GO3R/Makerbot-RFID-Cloner/Pictures/IMG_20241216_104319149.jpg

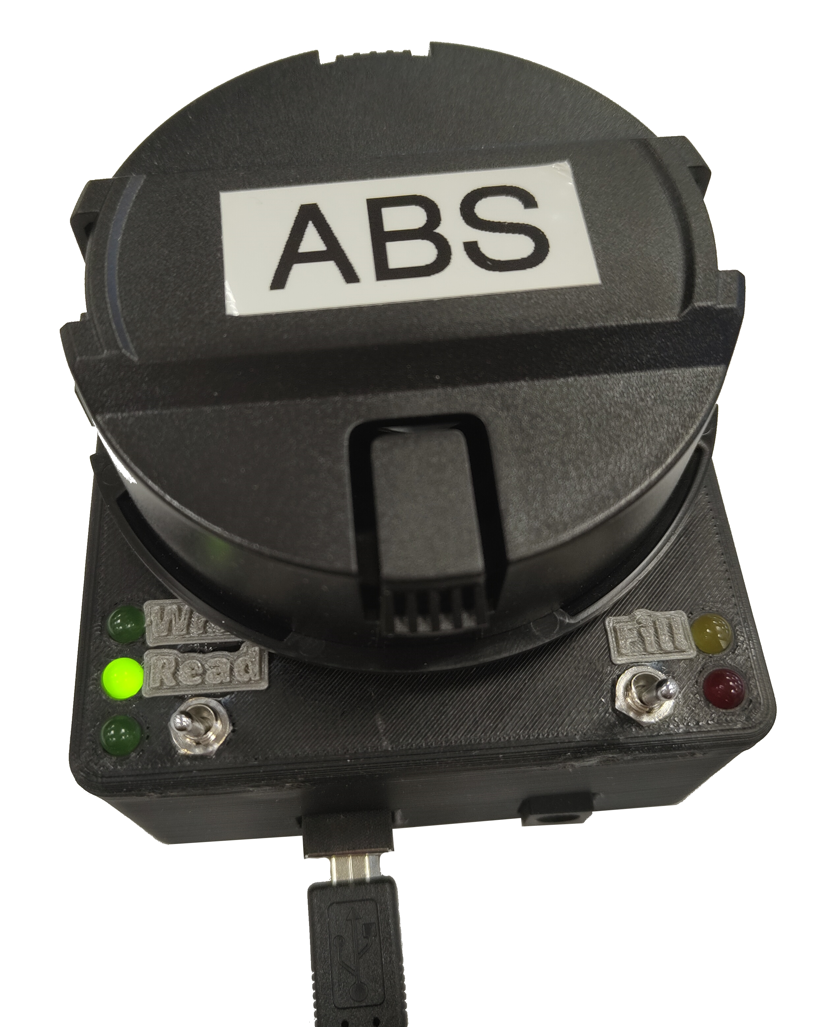
Pictures/IMG_20241216_104319149.jpg
