GO3R/Makerbot-RFID-Cloner/Pictures/IMG_20250312_114838785.jpg

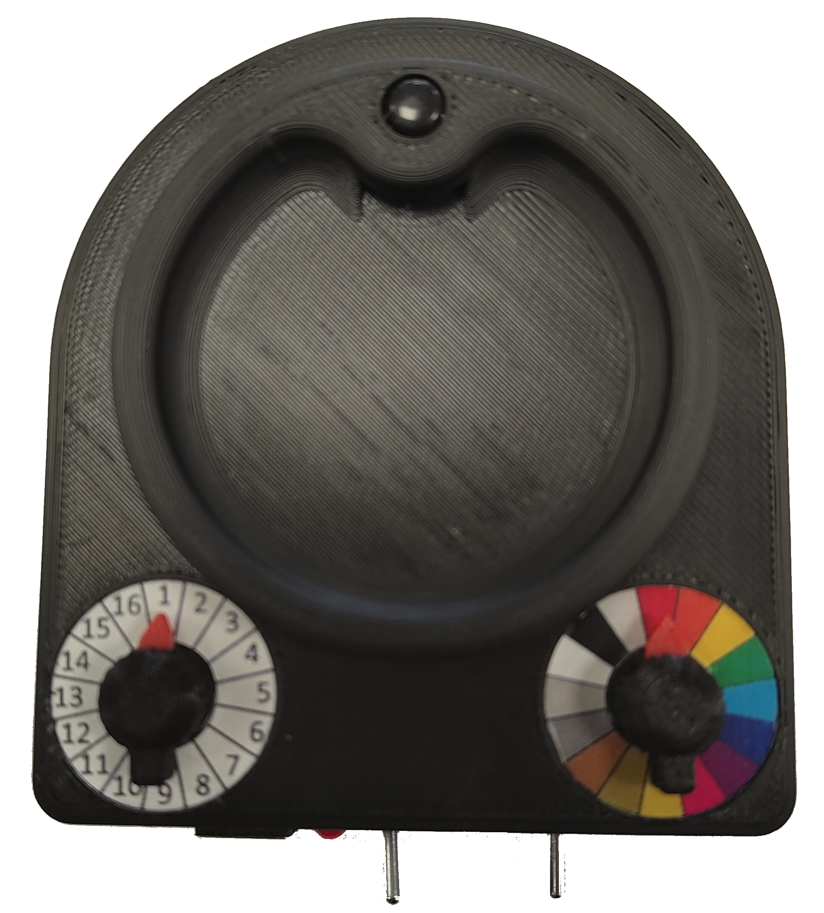
Pictures/IMG_20250312_114838785.jpg
