GO3R/Makerbot-RFID-Cloner/README.md

Two versions available! 

I have a lot of empty SR-30 spools and i respool them with ABS (its way cheaper than buing original from Makerbot). The one problem with that is, i only have one ABS RFID chip. So i made my own RFID cloner for these chips.

You can only duplicate existing RFID tags from your spools. You can not use this product to make a new material. 

I "reverse engeneered" the original RFID tag contents for you, but i will not share that. Makerbot please do not sue me :) 

You need the following Library: https://github.com/ATrappmann/PN5180-Library

3D-Model and circuit board (both not necessary for the function, but it looks nicer) is attached. Hard wiring is possible, but extremely difficult, because you dont have much space in the enclosure. 

Version 2.0 of my Makerbot Method X RFID Coil Cloner is finally finished. Unfortunately, I had to remove the clone function, but you can still select all 16 materials and 16 different colors and read the tag in the serial monitor. Plus, you can now use the device from anywhere thanks to the integrated 9V battery.

I removed four LEDs because I needed the pins from the Arduino, so only one 220 ohm resistor is needed. A switch (previously used to fill the coil) was repurposed. This switches the battery supply to the Arduino. Pull-up resistors are now used for the switches and buttons, making the 10k ohm resistors unnecessary. The circuit board has been completely redesigned. Two OTAX KMR162s were added to allow material and color selection.

Unfortunately, I don't have all the materials, so the machine can't create them all. I have ABS, ASA, Nylon, NylonCF, PC-ABS, PETG, PLA, Tough, PVA, and SR-30. I don't have the MakerBot hex code for any other materials. If you have these materials, please send me the hex code (the output from the serial monitor). I will then expand the code a little bit until it's complete.

V2.1: I have addet two more Materials NylonCF and Tough (that is the special more tough PLA). To update from V2 to V2.1, you only need to flash the new Makerbot_RFIDV2.1.ino on your RFID Cloner.

V2.2: We now have ABS-R thanks to https://github.com/kosmostrater.

V2.3: We now have Nylon12CF thanks to https://github.com/domomb .



HOW TO USE THIS PRODUCT IN V1________________________________________________________________________________________

The first switch is switching between read and write. (one green LED is a status LED, one is for read and one is for write)

With the second switch you can choose to fill up the spool or not (Yellow LED on = fill spool).

You can start the read and write function with the button. The LED is blinking, when its either reading or writing. 

Green status LED = Success

Red status LED = Something went wrong (You can see what in the serial monitor on your PC)

You can read one RFID tag and copy it as often as you want.

You can not read one RFID tag and write to the same with the same data (you can't "fill" the spool directly)

HOW TO USE THIS PRODUCT IN V2________________________________________________________________________________________

One switch ist an OnOff switch, the other is the Read-Write selector switch. 

Select read and connect the device to your computer with a serial monitor. add an RFID Tag and read it.

Select write, a material and a colour, add the RFID Tag and write the material. 

HARDWARE YOU NEED V1________________________________________________________________________________________

1X Arduino UNO R3 (https://www.reichelt.de/arduino-uno-rev-3-dip-variante-atmega328-usb-arduino-uno-dip-p154902.html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)

1X Adafruit bidirectional level shifter (https://www.reichelt.de/entwicklerboards-bidirektionaler-logikpegelkonverter-4-kanal--debo-logic-4ch-p235503.html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)

1X PN5180 RFID Reader (I only found them for sale in China ; https://www.ebay.de/itm/162768430788?srsltid=AfmBOop9j9C-VffmtjEJo-Qw5yhp8ghc4ka8X3xlJzSkLfzv2_8m_6zh)

1X Button (https://www.reichelt.de/miniatur-drucktaster-0-5a-24vac-1x-ein-sw-t-113a-sw-p45167.html?&trstct=vrt_pdn&nbc=1)

2X Switch (https://www.reichelt.de/kippschalter-6a-125vac-1x-ein-ein-ms-500a-p13150.html?&trstct=pol_0&nbc=1)

3X LED Green (https://www.reichelt.de/led-5mm-bedrahtet-gruen-2000-mcd-60--5034g3d-esa-a-p361637.html?&trstct=pos_7&nbc=1)

1X LED Yellow (https://www.reichelt.de/led-5mm-bedrahtet-gelb-130-mcd-60--5003y1d-ehb-a-p361633.html?&trstct=pos_5&nbc=1)

1X LED Red (https://www.reichelt.de/led-5-mm-bedrahtet-rot-fr-led-5-rd-dif-p230933.html?&trstct=pos_1&nbc=1)

5X 220Ohm Resistor (https://www.reichelt.de/widerstand-metallschicht-220-ohm-0207-0-6-0-1--mpr-220-p12875.html?&trstct=pos_0&nbc=1)

4X 10KOhm Resistor (https://www.reichelt.de/widerstand-metallschicht-10-kohm-axial-1-w-5--vis-pr0100010105-p237110.html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)

JST XH connectors, i buy them in a set (https://www.ebay.de/itm/175923966477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)
(7X 2Pin, 1X 3Pin, 1X 4Pin, 1X5Pin)

2X female headers 6 pin (https://www.reichelt.de/buchsenleisten-2-54-mm-1x06-gerade-mpe-094-1-006-p119915.html?&trstct=pol_7&nbc=1) (you don't need them, if you solder the level shifter in place)

1X male headers (https://www.reichelt.de/stiftleisten-2-54-mm-1x24-gerade-mpe-087-1-024-p119889.html?&trstct=pol_11&nbc=1) (you need at least 19 Pins for the Arduino and 12 for the level shifter)

8X M3x5 screw (https://www.ebay.de/itm/371713576275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) (for fixing the RFID reader and the Arduino)

4X M3x10 screw (https://www.ebay.de/itm/371713576275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) (for closing the enclosure)

12X M3x4 Heat set insert (https://www.ebay.de/itm/365099517164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) (Optional)

Soldering iron and wires to connect it

3D Printer for the case

HARDWARE YOU NEED V2________________________________________________________________________________________

1X Arduino UNO R3 (https://www.reichelt.de/arduino-uno-rev-3-dip-variante-atmega328-usb-arduino-uno-dip-p154902.html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)

1X Adafruit bidirectional level shifter (https://www.reichelt.de/entwicklerboards-bidirektionaler-logikpegelkonverter-4-kanal--debo-logic-4ch-p235503.html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)

1X PN5180 RFID Reader (I only found them for sale in China ; https://www.ebay.de/itm/162768430788?srsltid=AfmBOop9j9C-VffmtjEJo-Qw5yhp8ghc4ka8X3xlJzSkLfzv2_8m_6zh)

1X Button (https://www.reichelt.de/miniatur-drucktaster-0-5a-24vac-1x-ein-sw-t-113a-sw-p45167.html?&trstct=vrt_pdn&nbc=1)

2X Switch (https://www.reichelt.de/kippschalter-6a-125vac-1x-ein-ein-ms-500a-p13150.html?&trstct=pol_0&nbc=1)

1X LED Red (https://www.reichelt.de/led-5-mm-bedrahtet-rot-fr-led-5-rd-dif-p230933.html?&trstct=pos_1&nbc=1)

1X 220Ohm Resistor (https://www.reichelt.de/widerstand-metallschicht-220-ohm-0207-0-6-0-1--mpr-220-p12875.html?&trstct=pos_0&nbc=1)

JST XH connectors, i buy them in a set (https://www.ebay.de/itm/175923966477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)
(7X 2Pin, 1X 3Pin, 1X 4Pin, 1X5Pin)

2X female headers 6 pin (https://www.reichelt.de/buchsenleisten-2-54-mm-1x06-gerade-mpe-094-1-006-p119915.html?&trstct=pol_7&nbc=1) (you don't need them, if you solder the level shifter in place)

1X male headers (https://www.reichelt.de/stiftleisten-2-54-mm-1x24-gerade-mpe-087-1-024-p119889.html?&trstct=pol_11&nbc=1) (you need at least 19 Pins for the Arduino and 12 for the level shifter)

8X M3x5 screw (https://www.ebay.de/itm/371713576275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) (for fixing the RFID reader and the Arduino)

2X M3x10 screw (https://www.ebay.de/itm/371713576275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) (for closing the enclosure)

10X M3x4 Heat set insert (https://www.ebay.de/itm/365099517164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) (Optional)

2X OTAX KMR162 Switch (https://www.reichelt.de/de/de/shop/produkt/dreh-codierschalter_16-polig_mit_vertikal_achse-9434)

1X 9V Battery + Batteryclip (https://www.reichelt.de/de/de/shop/produkt/batterieclip_fuer_9-volt-block_vertikal-6665)

Soldering iron and wires to connect it

3D Printer for the case

RFID TAGS________________________________________________________________________________________

I use the old SR-30 RFID tags.

If you need new RFID tags, you can buy them easily (https://www.ebay.de/itm/364655662869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)

HOW TO CONNECT V1________________________________________________________________________________________

PN5180connection

HOW TO CONNECT V2________________________________________________________________________________________

PN5180connectionV2
