GO3R/Makerbot-RFID-Cloner/Pictures/IMG_20241216_082909616.jpg

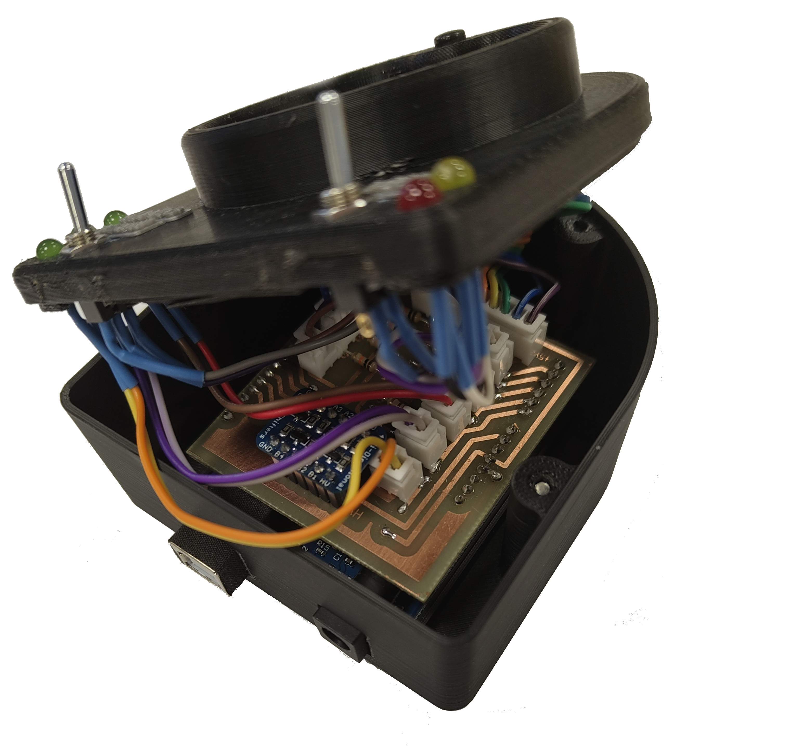
Pictures/IMG_20241216_082909616.jpg
