GO3R/Makerbot-RFID-Cloner/Pictures/IMG_20241216_103950372.jpg

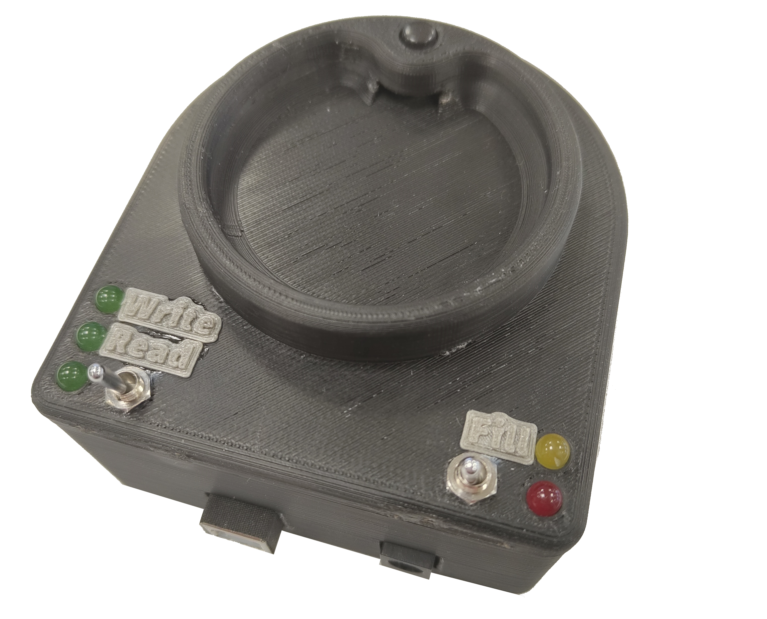
Pictures/IMG_20241216_103950372.jpg
