GO3R/Makerbot-RFID-Cloner/Pictures/IMG_20241216_142800873.jpg

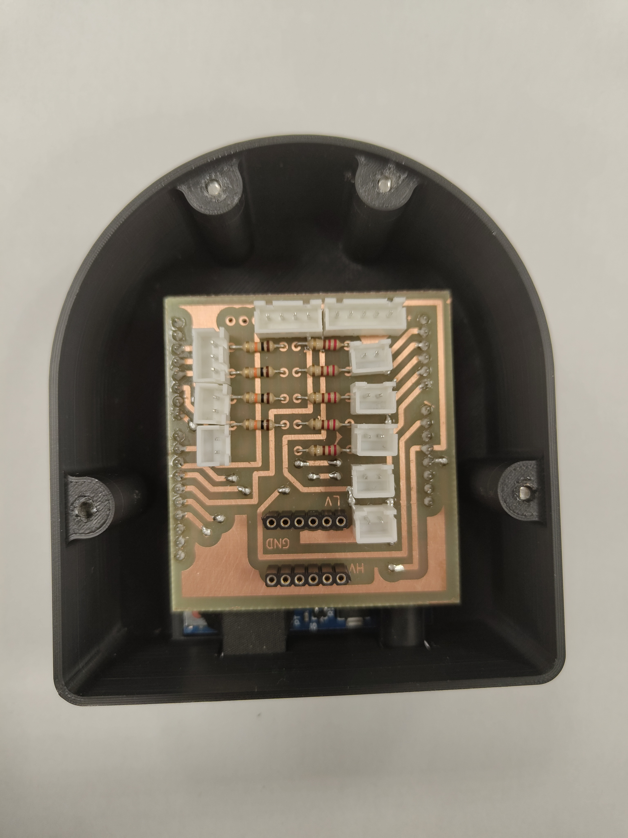
Pictures/IMG_20241216_142800873.jpg
