GO3R/Makerbot-RFID-Cloner/Pictures/IMG_20241216_1428008731.jpg

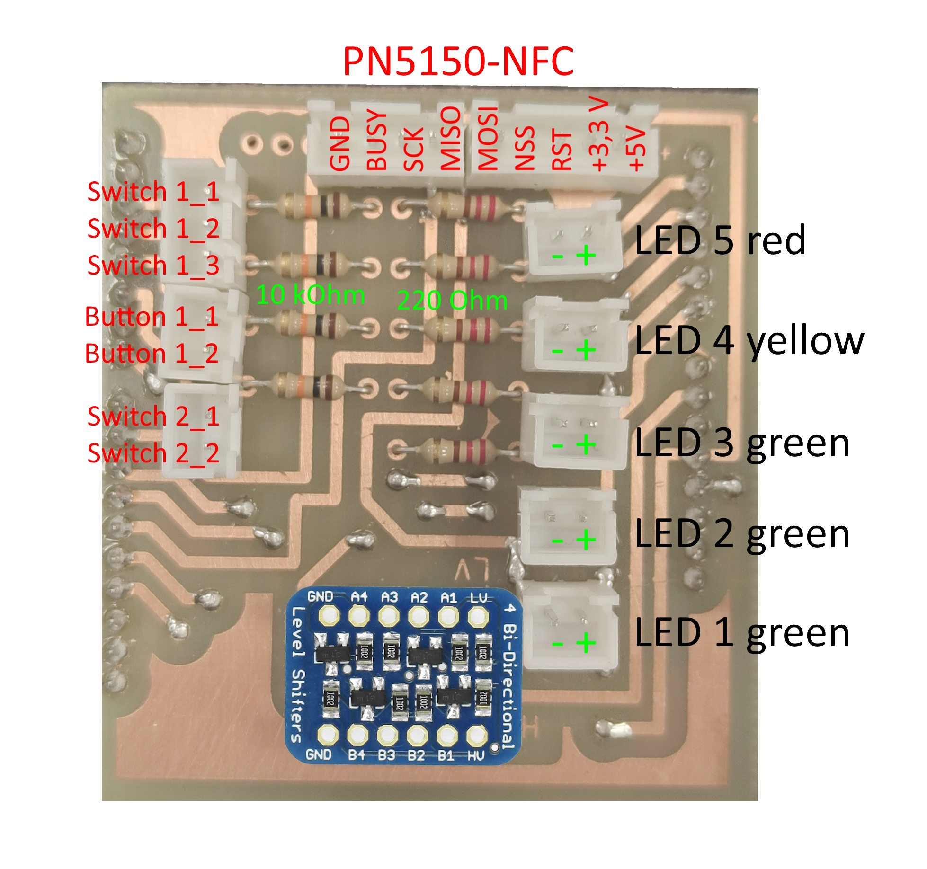
Pictures/IMG_20241216_1428008731.jpg
