GO3R/Makerbot-RFID-Cloner/Pictures/IMG_20250312_114823891.jpg

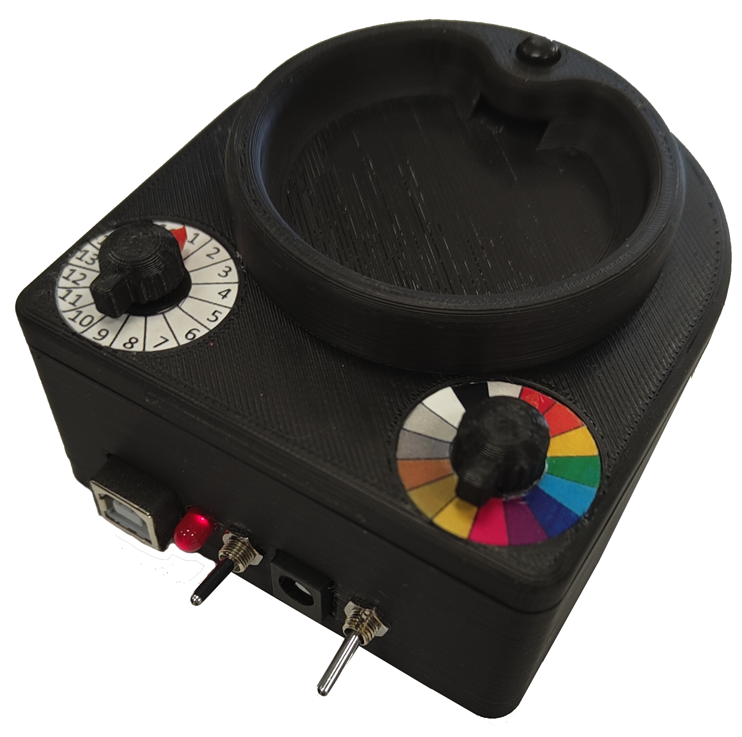
Pictures/IMG_20250312_114823891.jpg
