GO3R/Makerbot-RFID-Cloner/Pictures/IMG_20250312_114832706.jpg

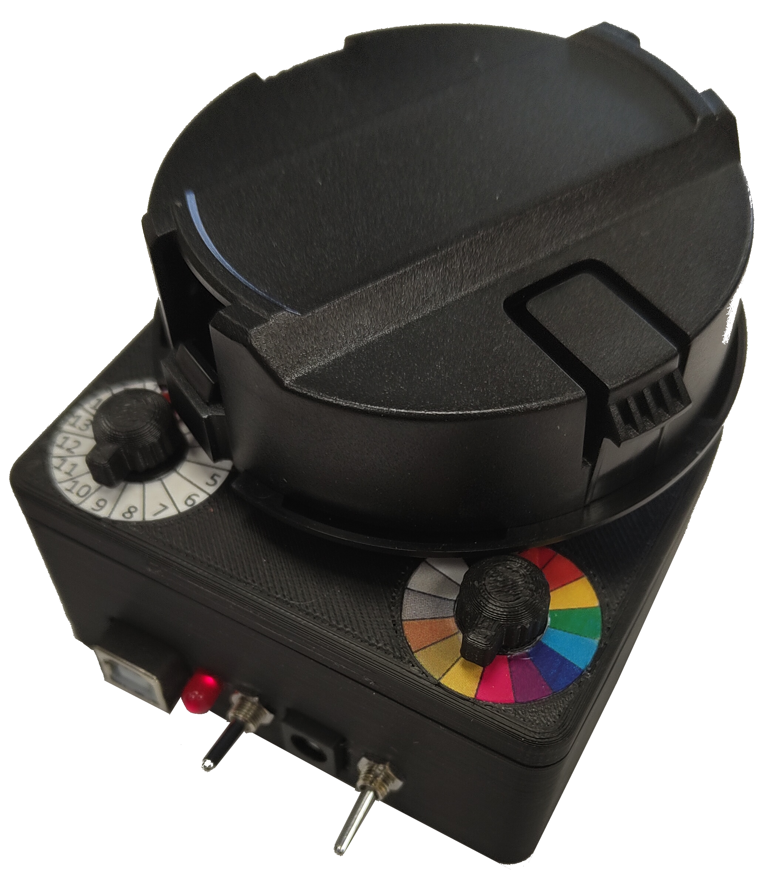
Pictures/IMG_20250312_114832706.jpg
