GO3R/Makerbot-RFID-Cloner/Pictures/IMG_20250312_114845302.jpg

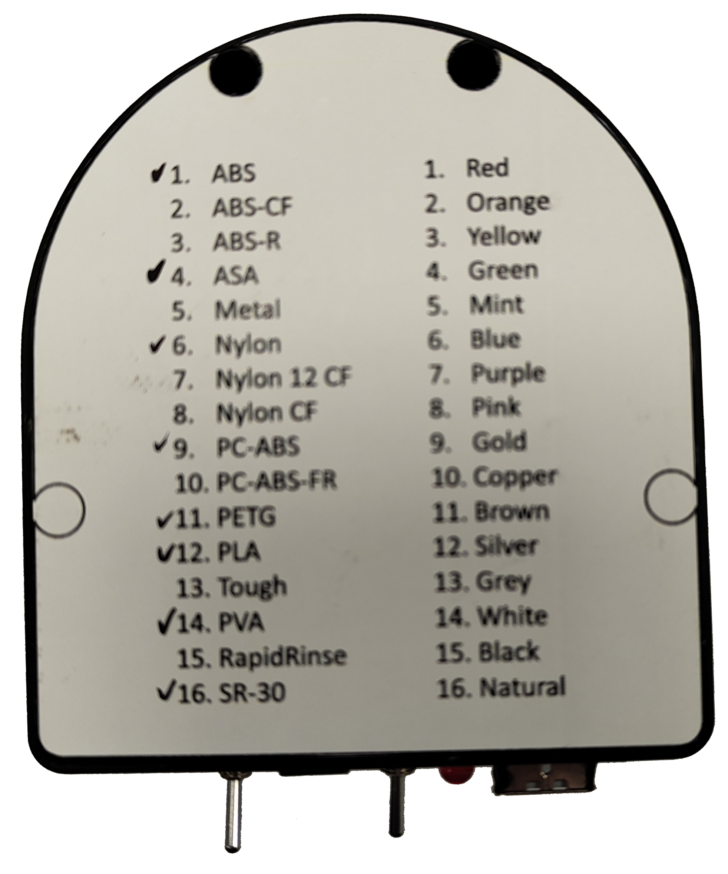
Pictures/IMG_20250312_114845302.jpg
