GO3R/Makerbot-RFID-Cloner/Pictures/Picture.PNG

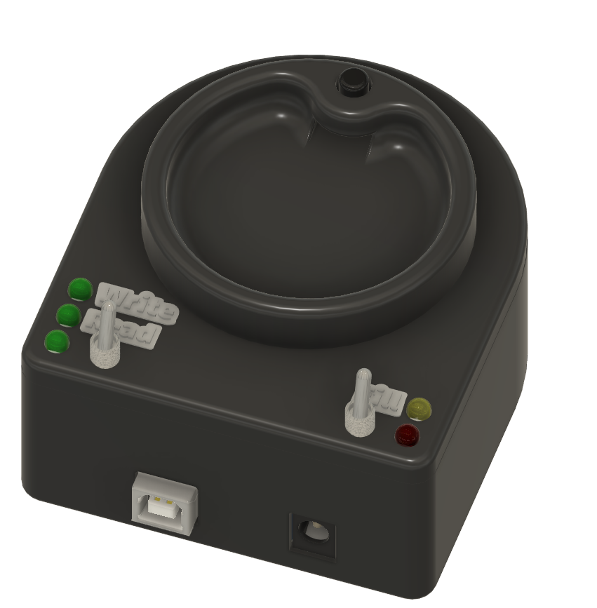
Pictures/Picture.PNG
