GO3R/Makerbot-RFID-Cloner/Pictures/PN5180connectionV2.png

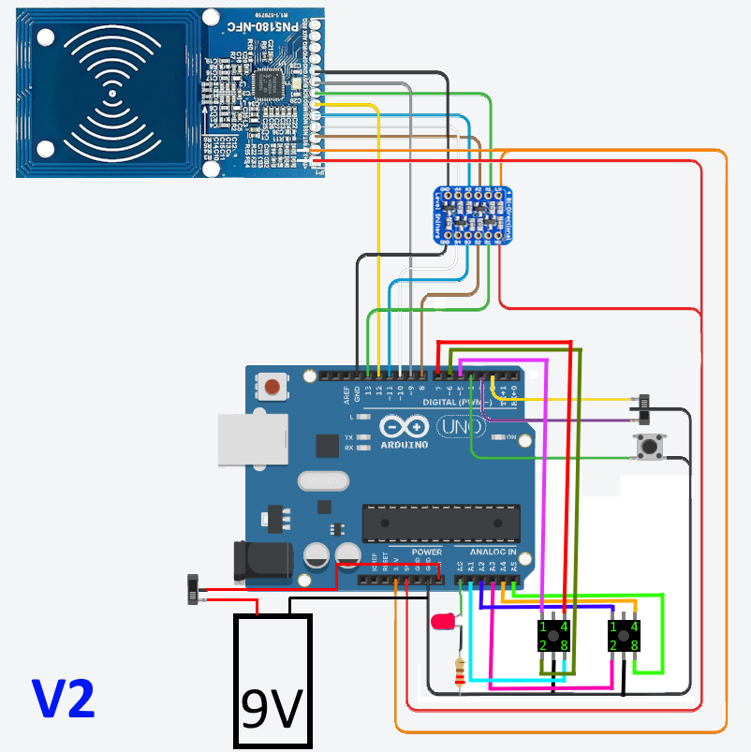
Pictures/PN5180connectionV2.png
