GO3R/Makerbot-RFID-Cloner/Pictures/SerialMonitor.PNG

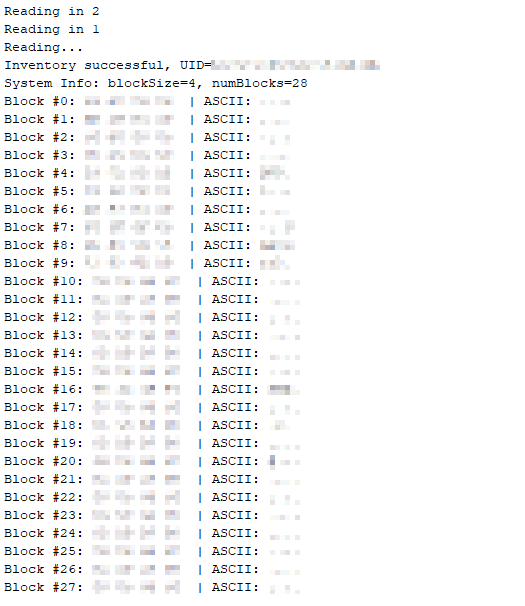
Pictures/SerialMonitor.PNG
