GO3R/Makerbot-RFID-Cloner/PN5180connection.png

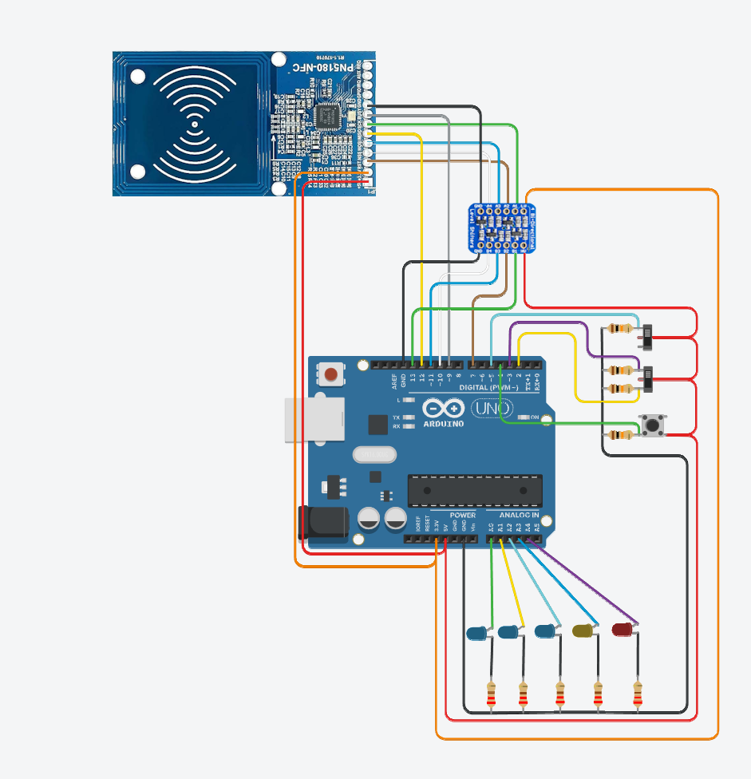
PN5180connection.png
